emtpb/et-ruler-lauflicht/(threads)

Thread 2 (2025-05-22):

Two links to interactive BOM

lndr, 2025-05-22:
The readme has two lines referring to the interactive BOM. I think this one is obsolete:
`An interactive html bom file with pcb layout and material placement can be found [here](bom/ibom.html).`

Closed 2025-05-23.
