emtpb/et-ruler-lauflicht/(commit log)

2023-08-24 Add first draft
    [et-ruler-Lauflicht.kicad_pcb, et-ruler-Lauflicht.kicad_sch]
2023-08-29 Add potentiometer and elco
    [et-ruler-Lauflicht.kicad_pcb, et-ruler-Lauflicht.kicad_sch]
2023-08-29 Fix pad alignment
    [et-ruler-Lauflicht.kicad_pcb]
2023-08-31 Add 'no connections'
    [et-ruler-Lauflicht.kicad_sch]
2023-08-31 Add logo and QR-Code
    [et-ruler-Lauflicht.kicad_pcb, et-ruler-Lauflicht.kicad_sch]
2023-09-01 Add THT batteryholder
2023-09-01 Place text and logos
    [et-ruler-Lauflicht.kicad_pcb]
2023-09-04 Dont connect V+ to outer pmods
    [et-ruler-Lauflicht.kicad_pcb, et-ruler-Lauflicht.kicad_sch]
2023-09-04 Add 2 1x6 connectors for the LED output
    [et-ruler-Lauflicht.kicad_pcb, et-ruler-Lauflicht.kicad_sch]
2023-09-04 Fix copper zones
    [et-ruler-Lauflicht.kicad_pcb]
2023-09-12 Add value for R4. Fix #3
    [et-ruler-Lauflicht.kicad_sch]
2023-09-12 Add scale to the back. Fix #2
    [et-ruler-Lauflicht.kicad_pcb, et-ruler-Lauflicht.kicad_sch]
2023-09-12 Fix errors by using symbols w/o pads for logo and qr-code
    [et-ruler-Lauflicht.kicad_sch]
2023-09-12 Increase distance between RV1 and C3 to Fix #1
    [et-ruler-Lauflicht.kicad_pcb]
2023-09-12 Add white zone below battery holder. Fix #5
    [et-ruler-Lauflicht.kicad_pcb]
2023-09-13 Add text to the switches. Fix #4
    [et-ruler-Lauflicht.kicad_pcb]
2023-09-13 Add additional battery holder footprint. Fix #6
    [et-ruler-Lauflicht.kicad_pcb, et-ruler-Lauflicht.kicad_sch]
2023-09-13 Use correct versioning
    [et-ruler-Lauflicht.kicad_pcb]
2023-09-13 Use smaller QR-code since the large one doesnt fit anymore
    [et-ruler-Lauflicht.kicad_pcb, et-ruler-Lauflicht.kicad_sch]
2023-09-13 Tidy up schematic and small fixes
    [et-ruler-Lauflicht.kicad_pcb, et-ruler-Lauflicht.kicad_sch]
2023-09-13 Add schematic png to README
2023-09-25 Fix routing and nets
    [et-ruler-Lauflicht.kicad_pcb]
2023-09-25 Use ext. V_in from pmod
    [et-ruler-Lauflicht.kicad_pcb, et-ruler-Lauflicht.kicad_sch]
2023-10-17 Fix unconnected end
    [et-ruler-Lauflicht.kicad_pcb]
2023-10-17 Exclude mounting holes and scales from BOM
    [et-ruler-Lauflicht.kicad_pcb, et-ruler-Lauflicht.kicad_sch]
2023-10-24 Bump to revision 2.2
    [et-ruler-Lauflicht.kicad_pcb]
2023-10-24 More vias and small fixes
    [et-ruler-Lauflicht.kicad_pcb, et-ruler-Lauflicht.kicad_sch]
2023-10-29 Update labels
    [et-ruler-Lauflicht.kicad_pcb]
2023-11-24 Convert files to KiCad 7 format
    [et-ruler-Lauflicht.kicad_pcb, et-ruler-Lauflicht.kicad_sch]
2023-11-24 Move labels
    [et-ruler-Lauflicht.kicad_pcb]
2023-12-01 Remove unnecessary vias
    [et-ruler-Lauflicht.kicad_pcb]
2023-12-01 Use smaller font because of style reasons
    [et-ruler-Lauflicht.kicad_pcb]
2023-12-01 Bump to version 2.3
    [et-ruler-Lauflicht.kicad_pcb]
2023-12-03 Use inverted label for version tag
    [et-ruler-Lauflicht.kicad_pcb]
2023-12-03 Fix pmod height
    [et-ruler-Lauflicht.kicad_pcb]
2024-11-22 Add interactive BOM
2024-11-26 Convert to KiCad 8 format
    [et-ruler-Lauflicht.kicad_pcb, et-ruler-Lauflicht.kicad_sch]
2024-11-26 Fix ERC errors and warnings
    [et-ruler-Lauflicht.kicad_sch]
2024-11-26 Add rendering and update schematic png
2024-11-26 Add title, revision, date and company to schematic
    [et-ruler-Lauflicht.kicad_sch]
2025-05-22 Add interactive BOM link (#1)
